ShawnVictor/Reaction_Control_System/README.md

# Reaction_Control_System
This is a repository containing all of the design documents relating to my Reaction Control System (RCS).
