ShawnVictor/Reaction_Control_System/Processing Code/Cold_Steer_Control_Panel/data/Cold_Steer_P&ID.jpg

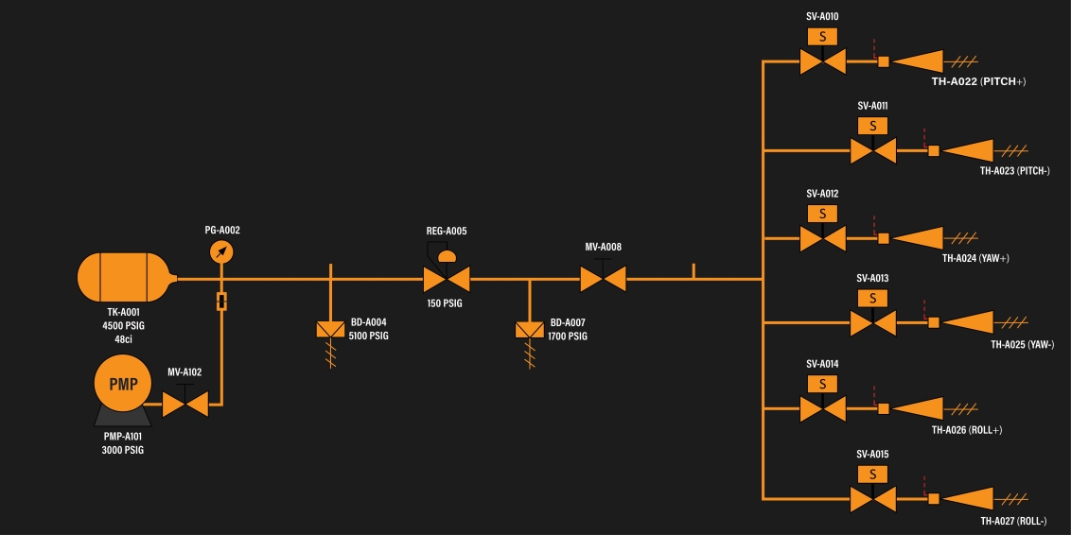
Processing Code/Cold_Steer_Control_Panel/data/Cold_Steer_P&ID.jpg
