ShawnVictor/Reaction_Control_System/Processing Code/Cold_Steer_Control_Panel/data/LRA_P&ID.jpg

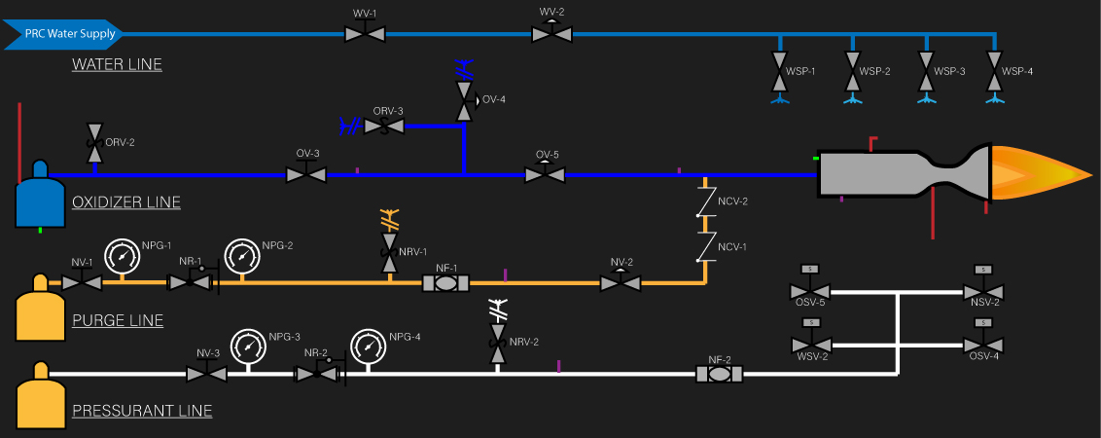
Processing Code/Cold_Steer_Control_Panel/data/LRA_P&ID.jpg
