ShawnVictor/Reaction_Control_System/Processing Code/Cold_Steer_Control_Panel/data/LRA_P&ID.png

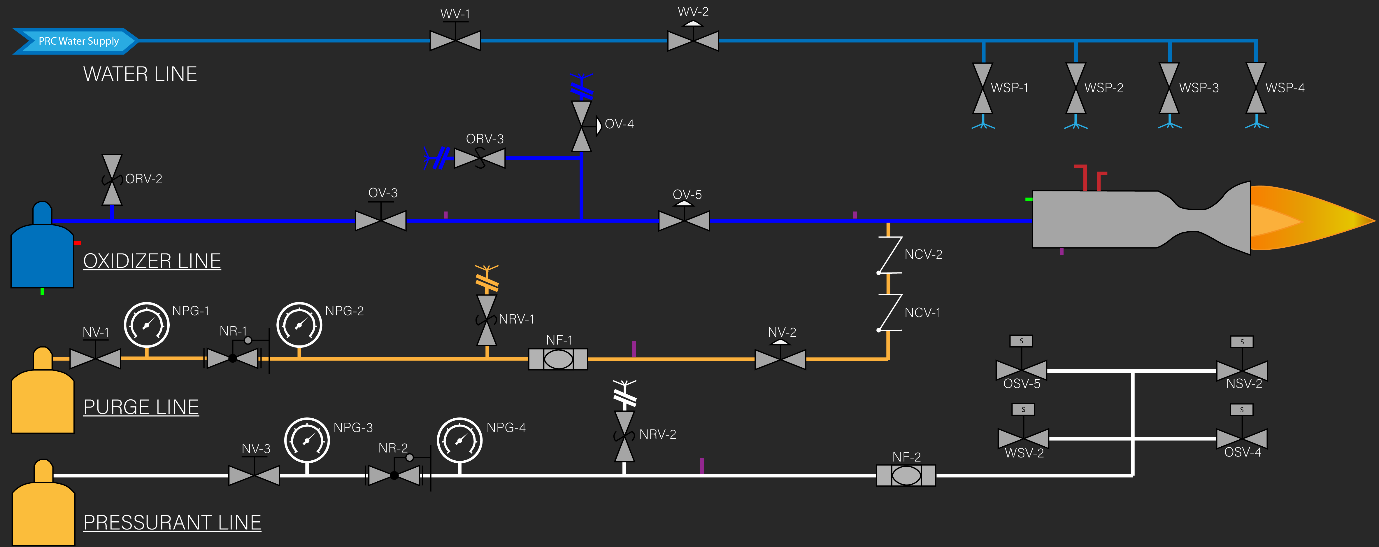
Processing Code/Cold_Steer_Control_Panel/data/LRA_P&ID.png
