ShawnVictor/Reaction_Control_System/PCB Files/Main_Control_Board/RCS_Metro_Telem_Board.brd

## EAGLE design PCB Files/Main_Control_Board/RCS_Metro_Telem_Board.brd (2024-12-17)

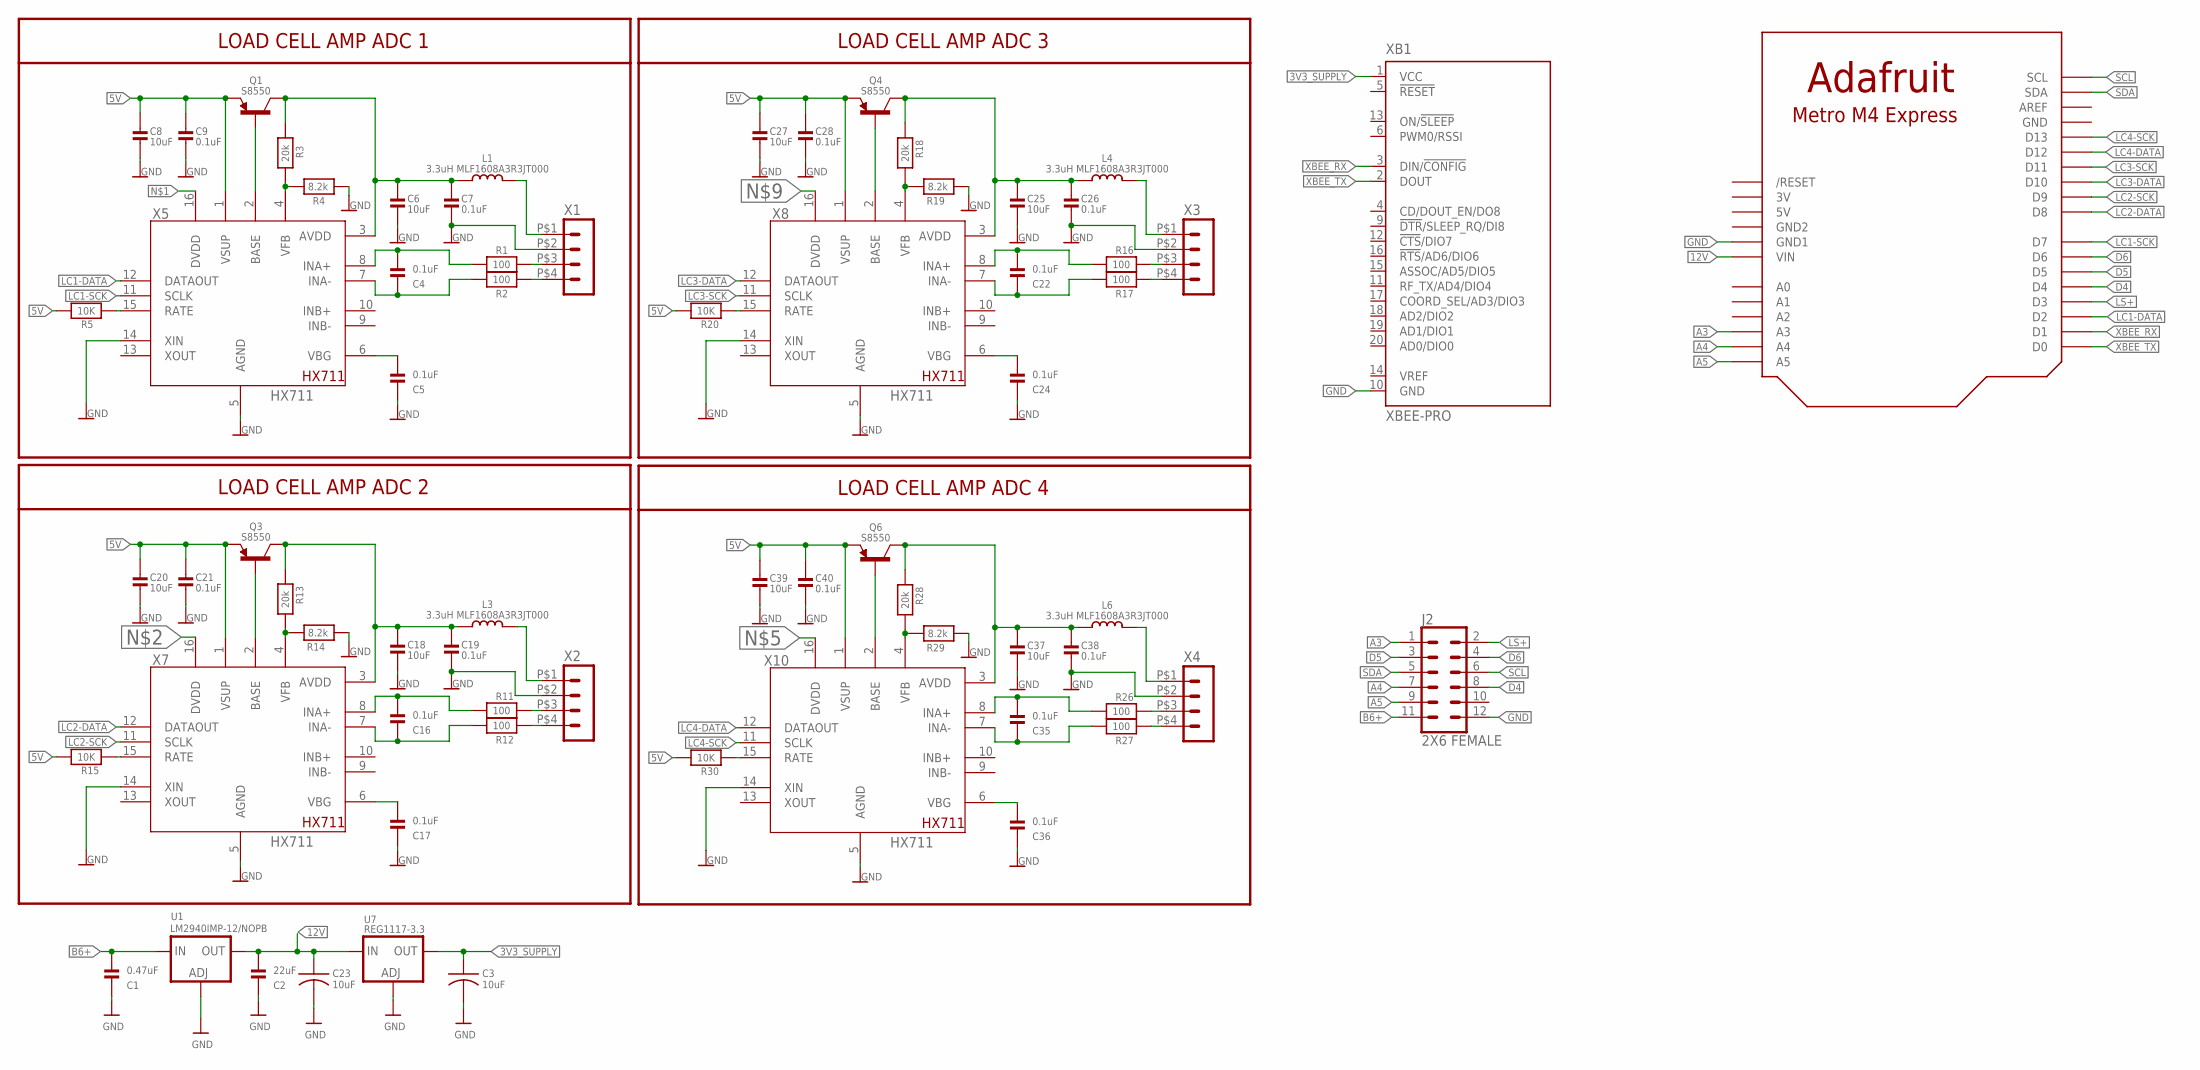
[picture p4: schematic RCS_Metro_Telem_Board.sch]

Parts:
C1: 0.47uF; 0603@1
C2: 22uF; 0603@1
C3, C23: 10uF; C0603
C4, C5, C7, C9, C16, C17, C19, C21, C22, C24, C26, C28, C35, C36, C38, C40: 0.1uF; 0603@1
C6, C8, C18, C20, C25, C27, C37, C39: 10uF; 0603@1
J2: 2X6 FEMALE; 2X6
L1, L3, L4, L6: 3.3uH MLF1608A3R3JT000; 0603-NO
Q1, Q3, Q4, Q6: S8550; SOT23-WIDE
R1, R2, R11, R12, R16, R17, R26, R27: 100; 0603@1
R3, R13, R18, R28: 20k; 0603@1
R4, R14, R19, R29: 8.2k; 0603@1
R5, R15, R20, R30: 10K; 0603@1
U1: LM2940IMP-12/NOPB; SOT223-R
U7: REG1117-3.3; SOT223-R
U$1: ADAFRUIT_METRO_M4_EXPRESS
X1, X2, X3, X4: HEADER_POS4_43650-0415; 43650-0415
X5, X7, X8, X10: HX711; SO16
XB1: XBEE-PRO

Connections:
3V: U$1.3V
3V3_SUPPLY: C3.1, U7.2 (OUT), XB1.1 (VCC)
5V: C8.2, C9.2, C20.2, C21.2, C27.2, C28.2, C39.2, C40.2, Q1.2 (E), Q3.2 (E), Q4.2 (E), Q6.2 (E), R5.1, R15.1, R20.1, R30.1, U$1.5V, X5.1 (VSUP), X7.1 (VSUP), X8.1 (VSUP), X10.1 (VSUP)
12V: C2.2, C23.1, U1.2 (OUT), U7.3 (IN), U$1.VIN
A3: J2.1, U$1.A3
A4: J2.7, U$1.A4
A5: J2.9, U$1.A5
B6+: C1.2, J2.11, U1.3 (IN)
D4: J2.8, U$1.D4
D5: J2.3, U$1.D5
D6: J2.4, U$1.D6
GND: C1.1, C2.1, C3.2, C5.1, C6.1, C7.1, C8.1, C9.1, C17.1, C18.1, C19.1, C20.1, C21.1, C23.2, C24.1, C25.1, C26.1, C27.1, C28.1, C36.1, C37.1, C38.1, C39.1, C40.1, J2.12, R4.1, R14.1, R19.1, R29.1, U1.1 (ADJ), U7.1 (ADJ), U$1.GND, U$1.GND1, X1.P$2 (2), X2.P$2 (2), X3.P$2 (2), X4.P$2 (2), X5.5 (AGND), X5.14 (XIN), X7.5 (AGND), X7.14 (XIN), X8.5 (AGND), X8.14 (XIN), X10.5 (AGND), X10.14 (XIN), XB1.10 (GND)
GND2: U$1.GND2
LC1-DATA: U$1.D2, X5.12 (DATAOUT)
LC1-SCK: U$1.D7, X5.11 (SCLK)
LC2-DATA: U$1.D8, X7.12 (DATAOUT)
LC2-SCK: U$1.D9, X7.11 (SCLK)
LC3-DATA: U$1.D10, X8.12 (DATAOUT)
LC3-SCK: U$1.D11, X8.11 (SCLK)
LC4-DATA: U$1.D12, X10.12 (DATAOUT)
LC4-SCK: U$1.D13, X10.11 (SCLK)
LS+: J2.2, U$1.D3
unnamed: R1.2, X1.P$3 (3)
unnamed: R2.2, X1.P$4 (4)
unnamed: C4.1, R2.1, X5.7 (INA-)
unnamed: C4.2, R1.1, X5.8 (INA+)
unnamed: C5.2, X5.6 (VBG)
unnamed: L1.2, X1.P$1 (1)
unnamed: R3.1, R4.2, X5.4 (VFB)
unnamed: Q1.1 (B), X5.2 (BASE)
unnamed: C6.2, C7.2, L1.1, Q1.3 (C), R3.2, X5.3 (AVDD)
unnamed: R5.2, X5.15 (RATE)
unnamed: R11.2, X2.P$3 (3)
unnamed: R12.2, X2.P$4 (4)
unnamed: C16.1, R12.1, X7.7 (INA-)
unnamed: C16.2, R11.1, X7.8 (INA+)
unnamed: C17.2, X7.6 (VBG)
unnamed: L3.2, X2.P$1 (1)
unnamed: R13.1, R14.2, X7.4 (VFB)
unnamed: Q3.1 (B), X7.2 (BASE)
unnamed: C18.2, C19.2, L3.1, Q3.3 (C), R13.2, X7.3 (AVDD)
unnamed: R15.2, X7.15 (RATE)
unnamed: R16.2, X3.P$3 (3)
unnamed: R17.2, X3.P$4 (4)
unnamed: C22.1, R17.1, X8.7 (INA-)
unnamed: C22.2, R16.1, X8.8 (INA+)
unnamed: C24.2, X8.6 (VBG)
unnamed: L4.2, X3.P$1 (1)
unnamed: R18.1, R19.2, X8.4 (VFB)
unnamed: Q4.1 (B), X8.2 (BASE)
unnamed: C25.2, C26.2, L4.1, Q4.3 (C), R18.2, X8.3 (AVDD)
unnamed: R20.2, X8.15 (RATE)
unnamed: R26.2, X4.P$3 (3)
unnamed: R27.2, X4.P$4 (4)
unnamed: C35.1, R27.1, X10.7 (INA-)
unnamed: C35.2, R26.1, X10.8 (INA+)
unnamed: C36.2, X10.6 (VBG)
unnamed: L6.2, X4.P$1 (1)
unnamed: R28.1, R29.2, X10.4 (VFB)
unnamed: Q6.1 (B), X10.2 (BASE)
unnamed: C37.2, C38.2, L6.1, Q6.3 (C), R28.2, X10.3 (AVDD)
unnamed: R30.2, X10.15 (RATE)
SCL: J2.6, U$1.SCL
SDA: J2.5, U$1.SDA
XBEE_RX: U$1.D1, XB1.3 (DIN/!CONFIG)
XBEE_TX: U$1.D0, XB1.2 (DOUT)

Notes on the sheet:
LOAD CELL AMP ADC 1
LOAD CELL AMP ADC 2
LOAD CELL AMP ADC 3
LOAD CELL AMP ADC 4

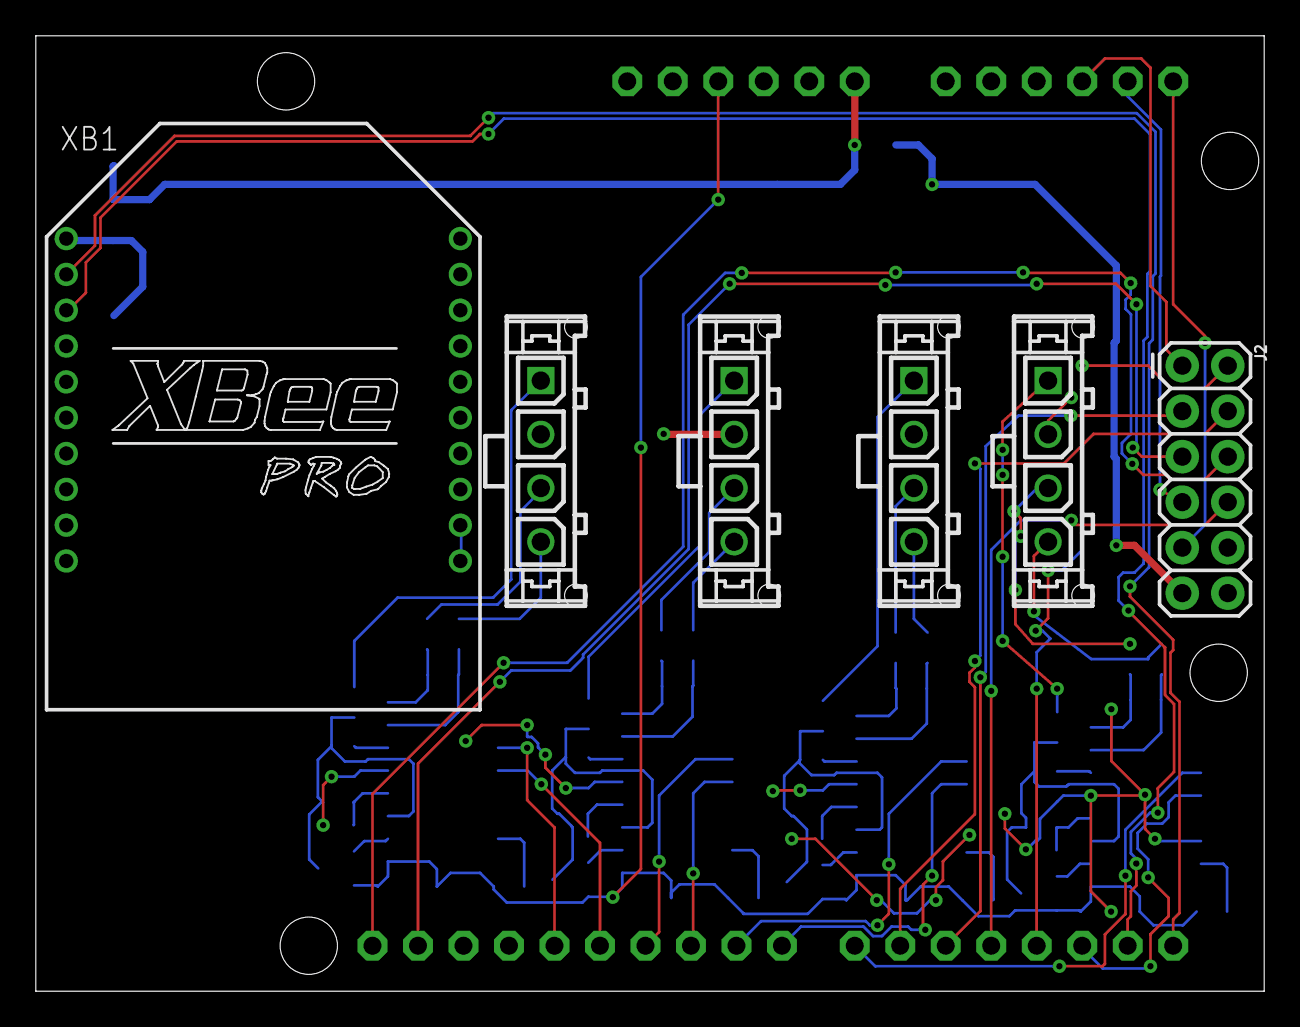
[picture p5: board RCS_Metro_Telem_Board.brd from above]

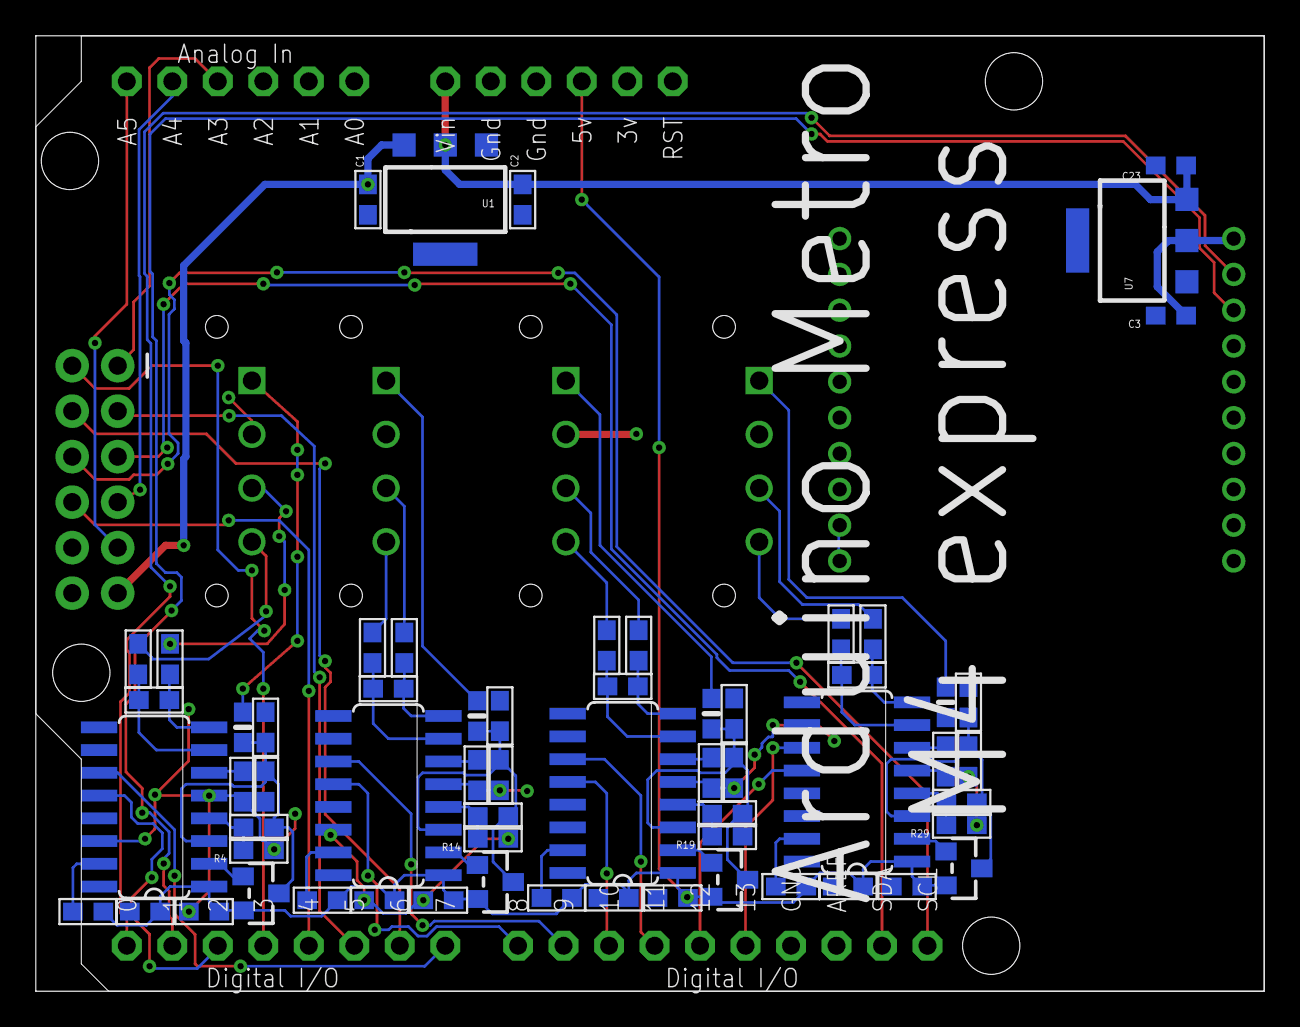
[picture p6: board RCS_Metro_Telem_Board.brd from below]

Board: 2 copper layers, 68.6 x 53.3 mm, 69 parts (63 on the bottom side), 64 nets.
