ShawnVictor/Reaction_Control_System/PCB Files/Battery_5S_Compression_Board/RCS_Battery_Pack_v2.brd

## EAGLE design PCB Files/Battery_5S_Compression_Board/RCS_Battery_Pack_v2.brd (2024-12-17)

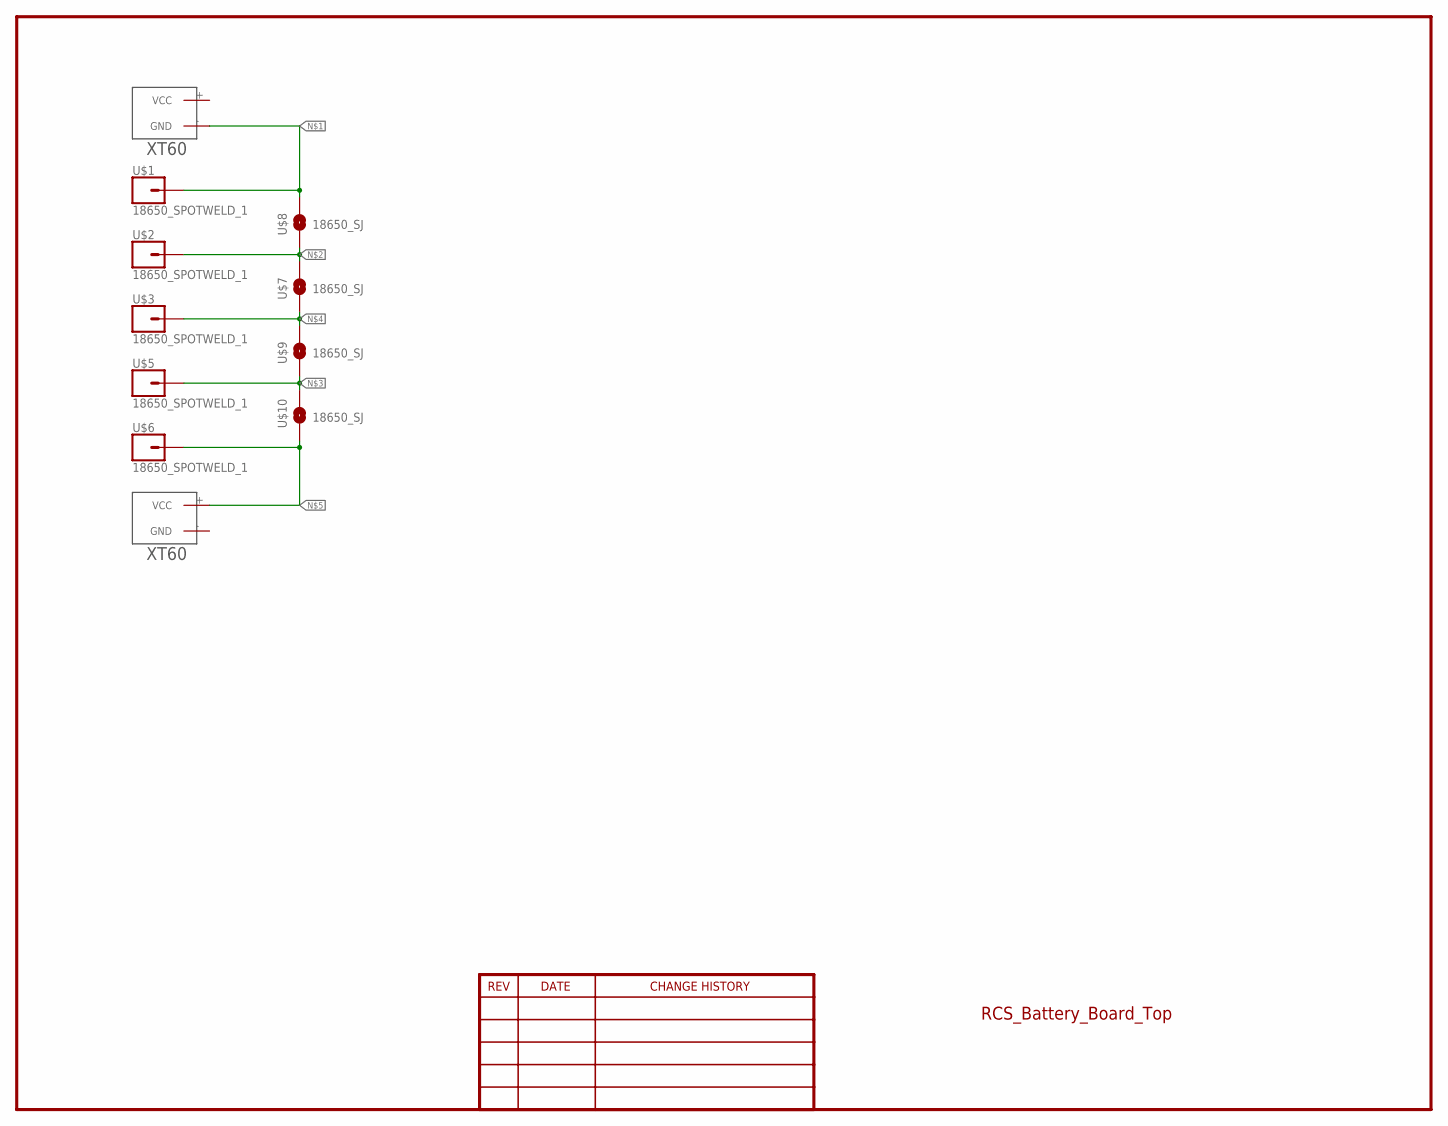
[picture p7: schematic RCS_Battery_Pack_v2.sch]

Parts:
U$1, U$2, U$3, U$5, U$6: 18650_SPOTWELD_1
U$4, U$11: XT60
U$7, U$8, U$9, U$10: 18650_SJ; SJ_2S-NO

Connections:
unnamed: U$1.1, U$4.- (GND), U$8.2
unnamed: U$2.1, U$7.2, U$8.1
unnamed: U$5.1, U$9.1, U$10.2
unnamed: U$3.1, U$7.1, U$9.2
unnamed: U$6.1, U$10.1, U$11.+ (VCC)

Notes on the sheet:
RCS_Battery_Board_Top

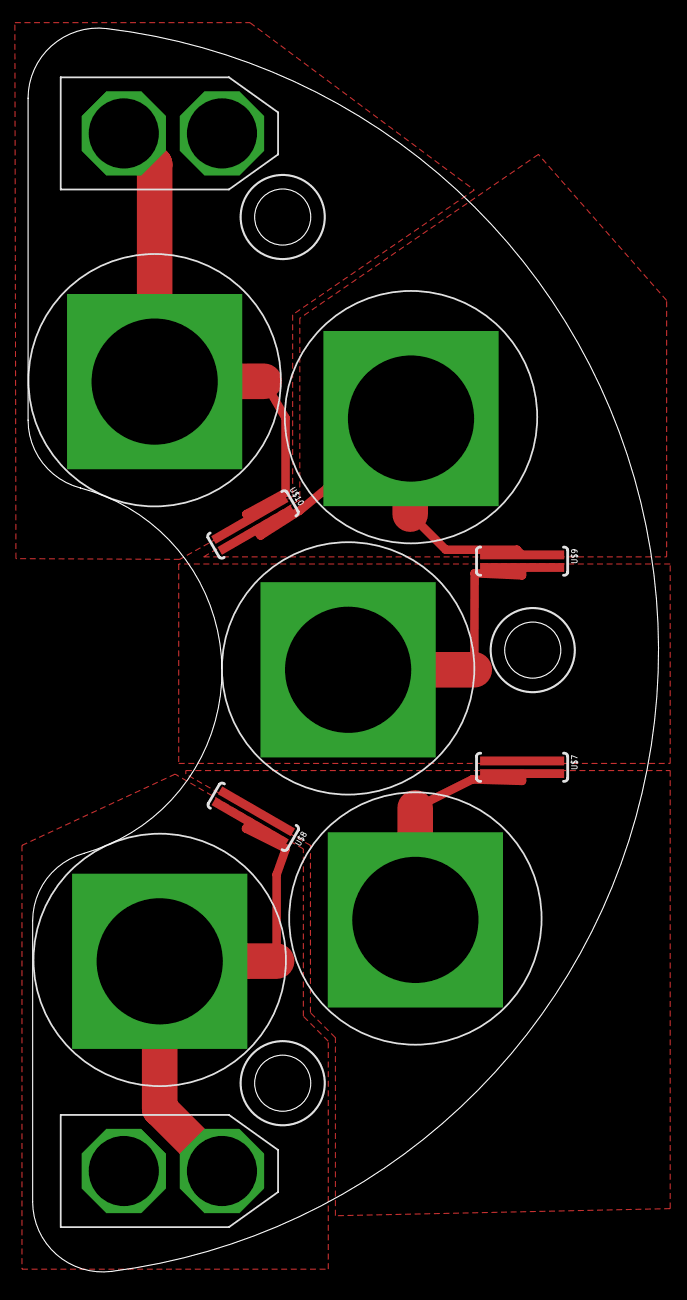
[picture p8: board RCS_Battery_Pack_v2.brd from above]

Board: 2 copper layers, 45.0 x 88.7 mm, 11 parts (0 on the bottom side), 5 nets.
