ShawnVictor/Reaction_Control_System/PCB Files/Main_Control_Board/RCS_Cntrl_Board.brd

## EAGLE design PCB Files/Main_Control_Board/RCS_Cntrl_Board.brd (2024-12-17)

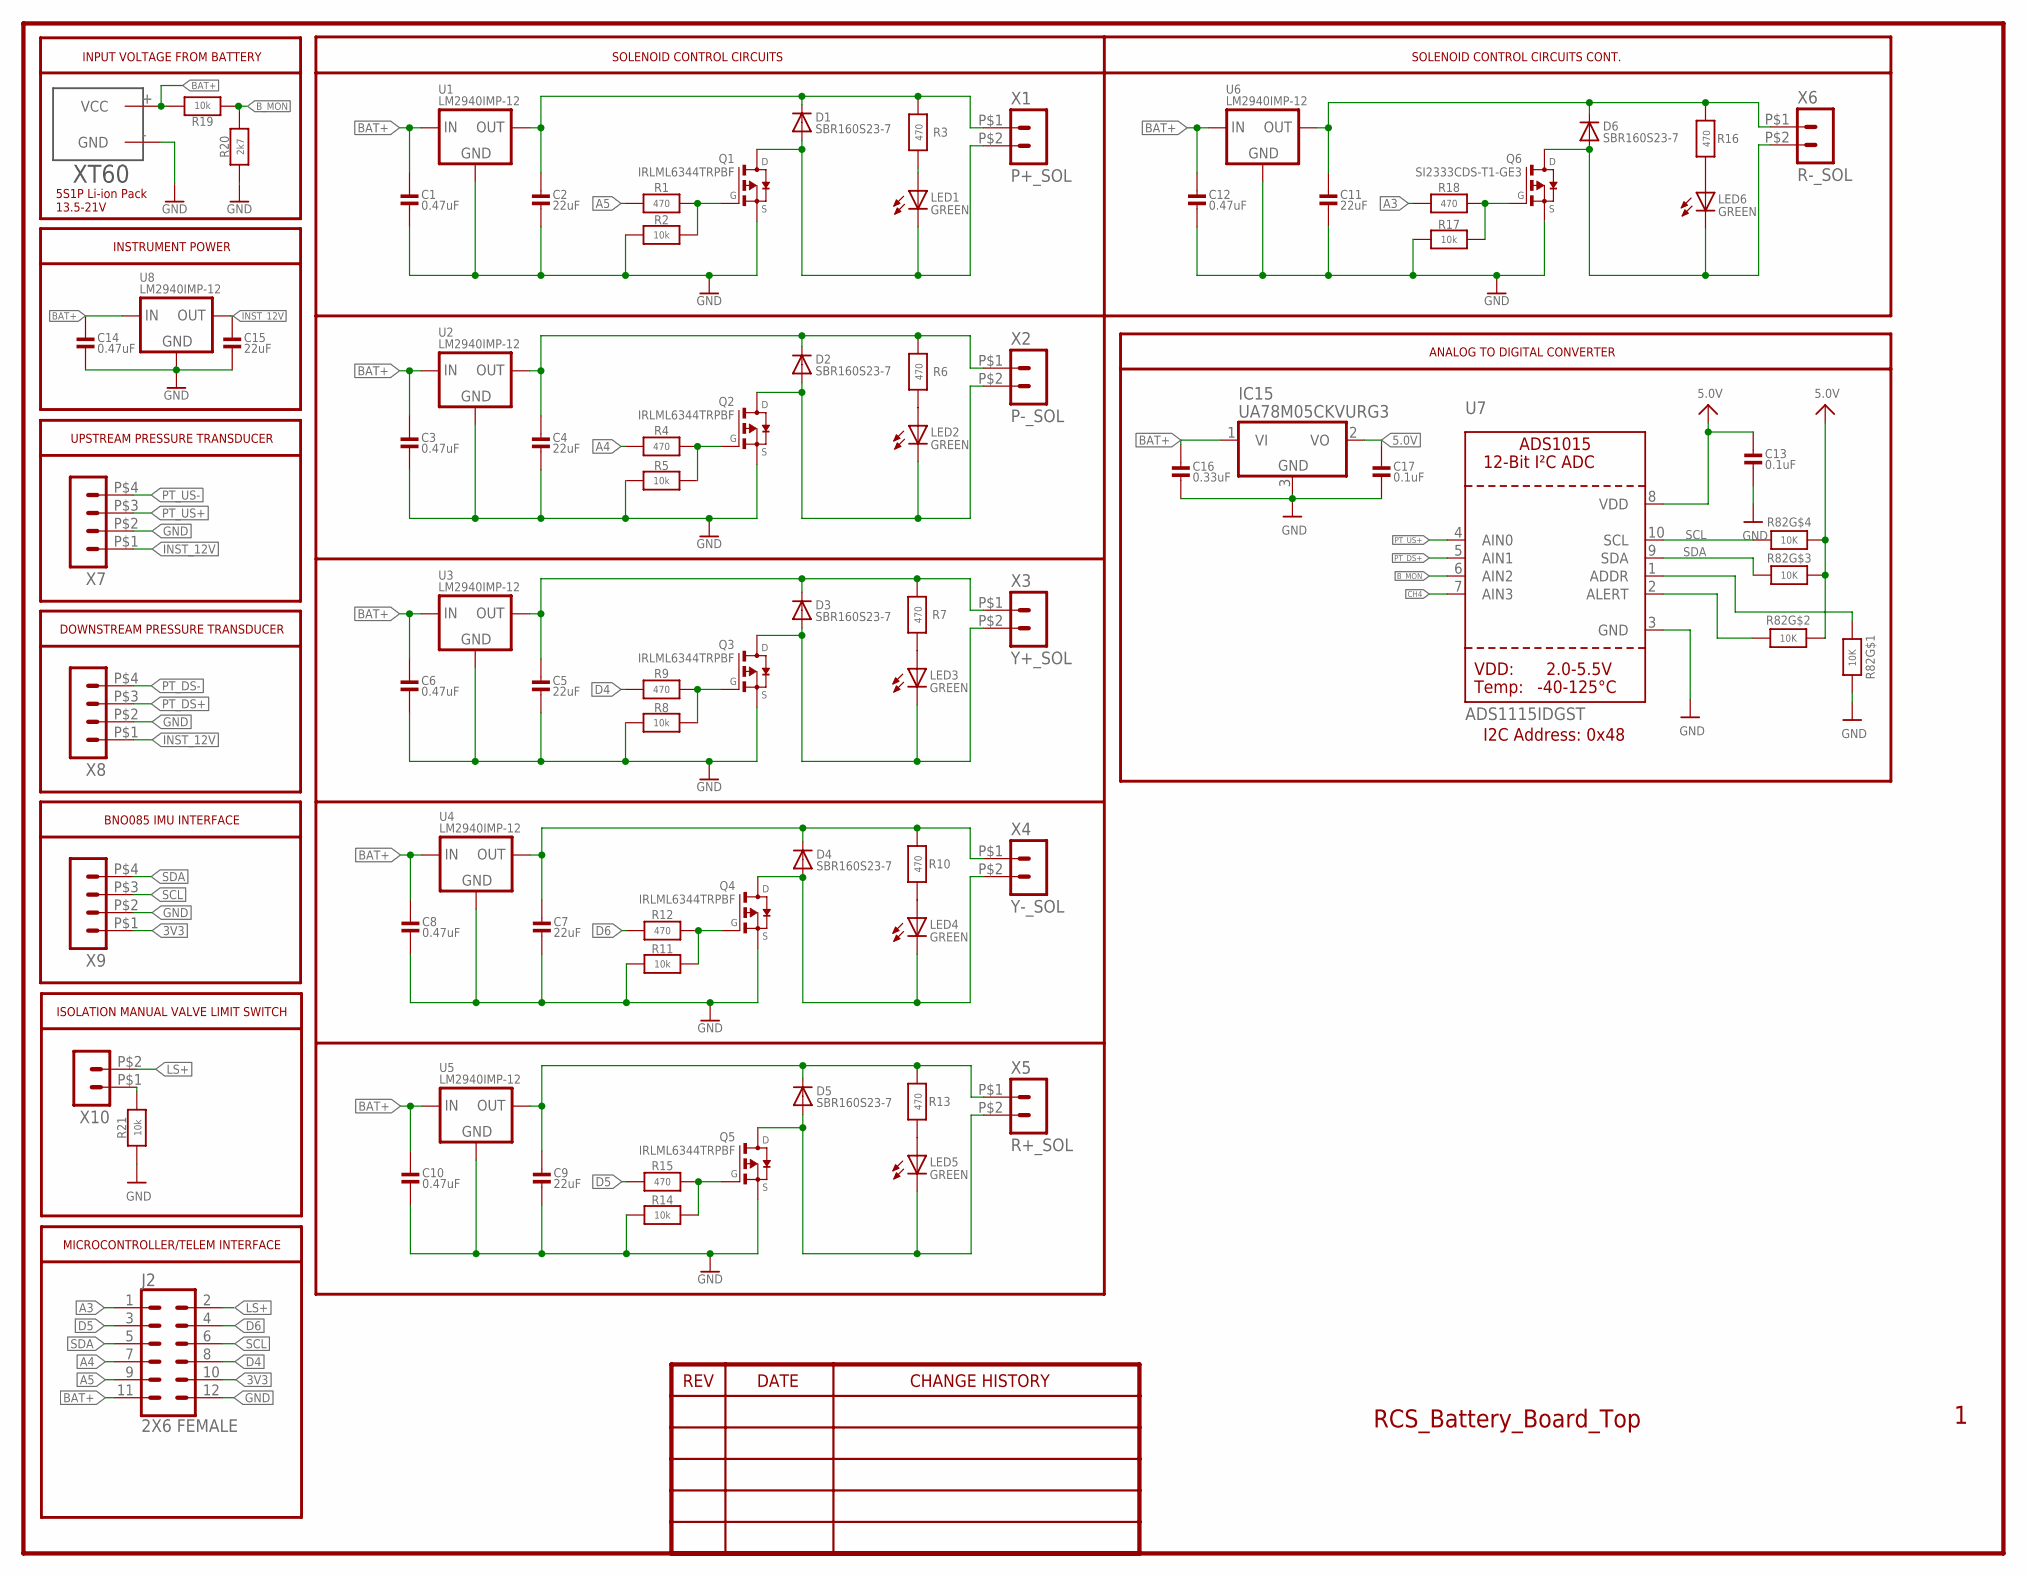
[picture p9: schematic RCS_Cntrl_Board.sch]

Parts:
C1, C3, C6, C8, C10, C12, C14: 0.47uF; 0603
C2, C4, C5, C7, C9, C11, C15: 22uF; 0603
C13, C17: 0.1uF; 0603
C16: 0.33uF; 0603
D1, D2, D3, D4, D5, D6: SBR160S23-7; SOT23-R
IC15: UA78M05CKVURG3; TO252
J2: 2X6 FEMALE; 2X6
LED1, LED2, LED3, LED4, LED5, LED6: GREEN; CHIPLED_0603
Q1, Q2, Q3, Q4, Q5: IRLML6344TRPBF; TRANSISTOR-FET_SOT23
Q6: SI2333CDS-T1-GE3; TRANSISTOR-FET_SOT23
R1, R3, R4, R6, R7, R9, R10, R12, R13, R15, R16, R18: 470; 0603-NO
R2, R5, R8, R11, R14, R17, R19, R21: 10k; 0603-NO
R20: 2k7; 0603-NO
R82: 10K; RESPACK_4X0603
U1, U2, U3, U4, U5, U6, U8: LM2940IMP-12; SOT223-R
U7: ADS1115IDGST; MSOP10
U$4: XT60
X1: P+_SOL; 44914-0201
X2: P-_SOL; 44914-0201
X3: Y+_SOL; 44914-0201
X4: Y-_SOL; 44914-0201
X5: R+_SOL; 44914-0201
X6: R-_SOL; 44914-0201
X7, X8, X9: HEADER_POS4_43650-0415; 43650-0415
X10: HEADER_POS2_43650-0215; 43650-0215

Connections:
3V3: J2.10, X9.P$1 (1)
5.0V: C13.2, C17.2, IC15.2 (VO), R82.5 (2), R82.6 (2), R82.7 (2), U7.8 (VDD)
A3: J2.1, R18.1
A4: J2.7, R4.1
A5: J2.9, R1.1
BAT+: C1.2, C3.2, C6.2, C8.2, C10.2, C12.2, C14.2, C16.2, IC15.1 (VI), J2.11, R19.2, U1.1 (IN), U2.1 (IN), U3.1 (IN), U4.1 (IN), U5.1 (IN), U6.1 (IN), U8.1 (IN), U$4.+ (VCC)
B_MON: R19.1, R20.2, U7.6 (AIN2)
CH4: U7.7 (AIN3)
D4: J2.8, R9.1
D5: J2.3, R15.1
D6: J2.4, R12.1
GND: C1.1, C2.1, C3.1, C4.1, C5.1, C6.1, C7.1, C8.1, C9.1, C10.1, C11.1, C12.1, C13.1, C14.1, C15.1, C16.1, C17.1, IC15.3 (GND), J2.12, Q1.2 (S), Q2.2 (S), Q3.2 (S), Q4.2 (S), Q5.2 (S), Q6.2 (S), R2.1, R5.1, R8.1, R11.1, R14.1, R17.1, R20.1, R21.1, R82.8 (2), U1.2 (GND), U2.2 (GND), U3.2 (GND), U4.2 (GND), U5.2 (GND), U6.2 (GND), U7.3 (GND), U8.2 (GND), U$4.- (GND), X7.P$2 (2), X8.P$2 (2), X9.P$2 (2)
INST_12V: C15.2, U8.3 (OUT), X7.P$1 (1), X8.P$1 (1)
LS+: J2.2, X10.P$2 (2)
unnamed: LED1.A, R3.1
unnamed: C2.2, D1.3 (C), R3.2, U1.3 (OUT), X1.P$1 (1)
unnamed: D2.1 (A), LED2.C, Q2.3 (D), X2.P$2 (2)
unnamed: LED2.A, R6.1
unnamed: Q2.1 (G), R4.2, R5.2
unnamed: D3.1 (A), LED3.C, Q3.3 (D), X3.P$2 (2)
unnamed: Q3.1 (G), R8.2, R9.2
unnamed: C4.2, D2.3 (C), R6.2, U2.3 (OUT), X2.P$1 (1)
unnamed: LED3.A, R7.1
unnamed: D4.1 (A), LED4.C, Q4.3 (D), X4.P$2 (2)
unnamed: D5.1 (A), LED5.C, Q5.3 (D), X5.P$2 (2)
unnamed: C5.2, D3.3 (C), R7.2, U3.3 (OUT), X3.P$1 (1)
unnamed: LED4.A, R10.1
unnamed: Q4.1 (G), R11.2, R12.2
unnamed: C7.2, D4.3 (C), R10.2, U4.3 (OUT), X4.P$1 (1)
unnamed: Q5.1 (G), R14.2, R15.2
unnamed: LED5.A, R13.1
unnamed: D6.1 (A), LED6.C, Q6.3 (D), X6.P$2 (2)
unnamed: Q6.1 (G), R17.2, R18.2
unnamed: C9.2, D5.3 (C), R13.2, U5.3 (OUT), X5.P$1 (1)
unnamed: LED6.A, R16.1
unnamed: C11.2, D6.3 (C), R16.2, U6.3 (OUT), X6.P$1 (1)
unnamed: R21.2, X10.P$1 (1)
unnamed: D1.1 (A), LED1.C, Q1.3 (D), X1.P$2 (2)
unnamed: Q1.1 (G), R1.2, R2.2
unnamed: R82.2 (1), U7.2 (ALERT)
unnamed: R82.1, U7.1 (ADDR)
PT_DS+: U7.5 (AIN1), X8.P$3 (3)
PT_DS-: X8.P$4 (4)
PT_US+: U7.4 (AIN0), X7.P$3 (3)
PT_US-: X7.P$4 (4)
SCL: J2.6, R82.4 (1), U7.10 (SCL), X9.P$3 (3)
SDA: J2.5, R82.3 (1), U7.9 (SDA), X9.P$4 (4)

Notes on the sheet:
RCS_Battery_Board_Top
INPUT VOLTAGE FROM BATTERY
5S1P Li-ion Pack
13.5-21V
SOLENOID CONTROL CIRCUITS
SOLENOID CONTROL CIRCUITS CONT.
ANALOG TO DIGITAL CONVERTER
I2C Address: 0x48
UPSTREAM PRESSURE TRANSDUCER
DOWNSTREAM PRESSURE TRANSDUCER
INSTRUMENT POWER
BNO085 IMU INTERFACE
ISOLATION MANUAL VALVE LIMIT SWITCH
MICROCONTROLLER/TELEM INTERFACE

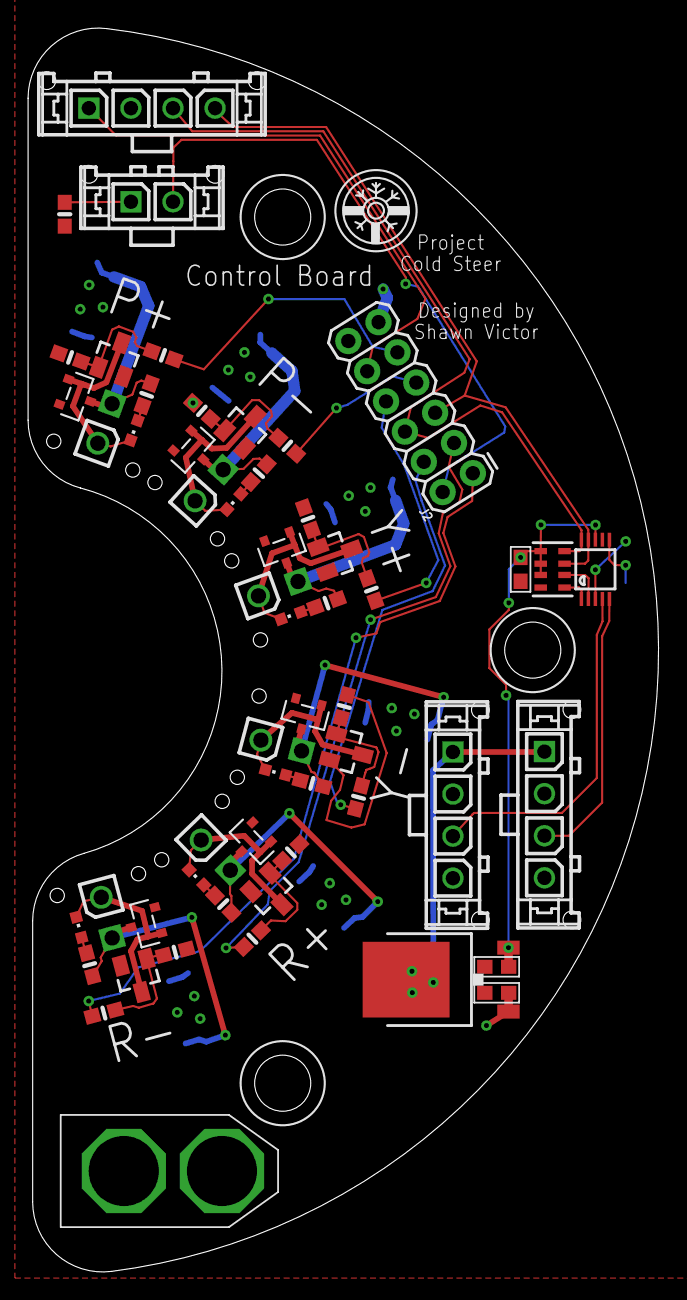
[picture p10: board RCS_Cntrl_Board.brd from above]

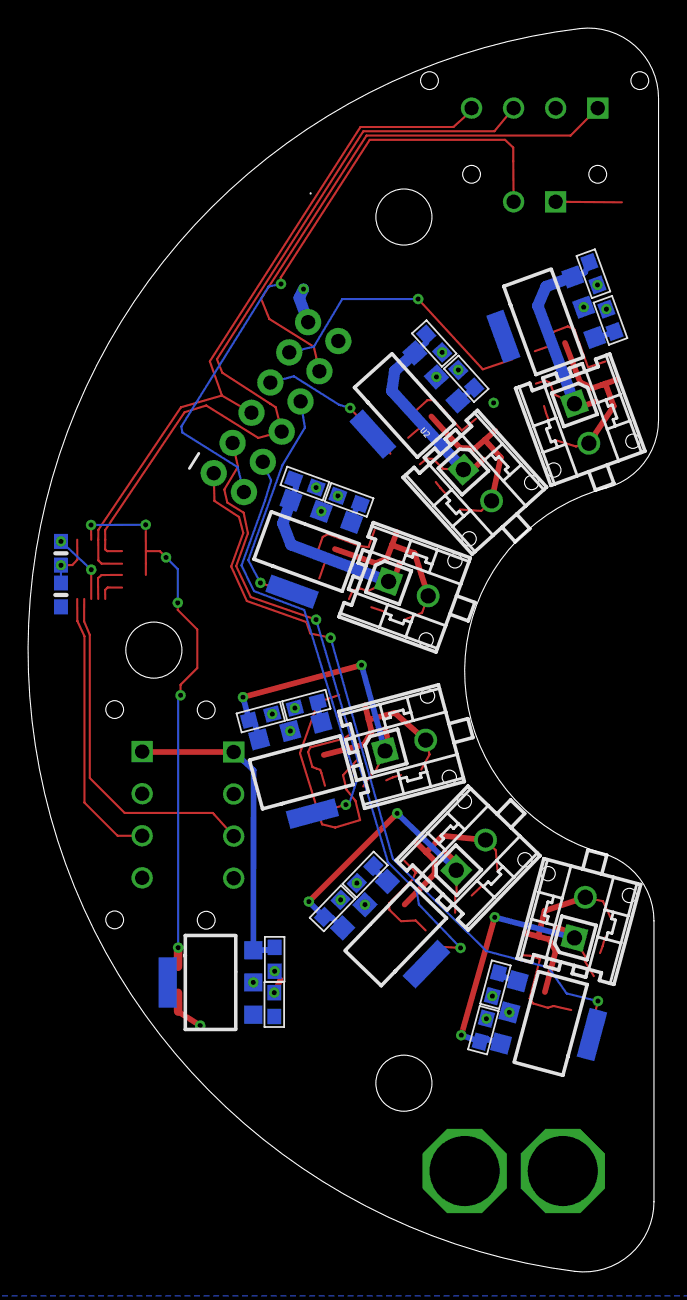
[picture p11: board RCS_Cntrl_Board.brd from below]

Board: 2 copper layers, 45.0 x 88.7 mm, 78 parts (29 on the bottom side), 44 nets.
