ShawnVictor/Reaction_Control_System/PCB Files/Compressor_Controller_Board/Compressor_Remote_Cntrl_Board.brd

## EAGLE design PCB Files/Compressor_Controller_Board/Compressor_Remote_Cntrl_Board.brd (2024-12-17)

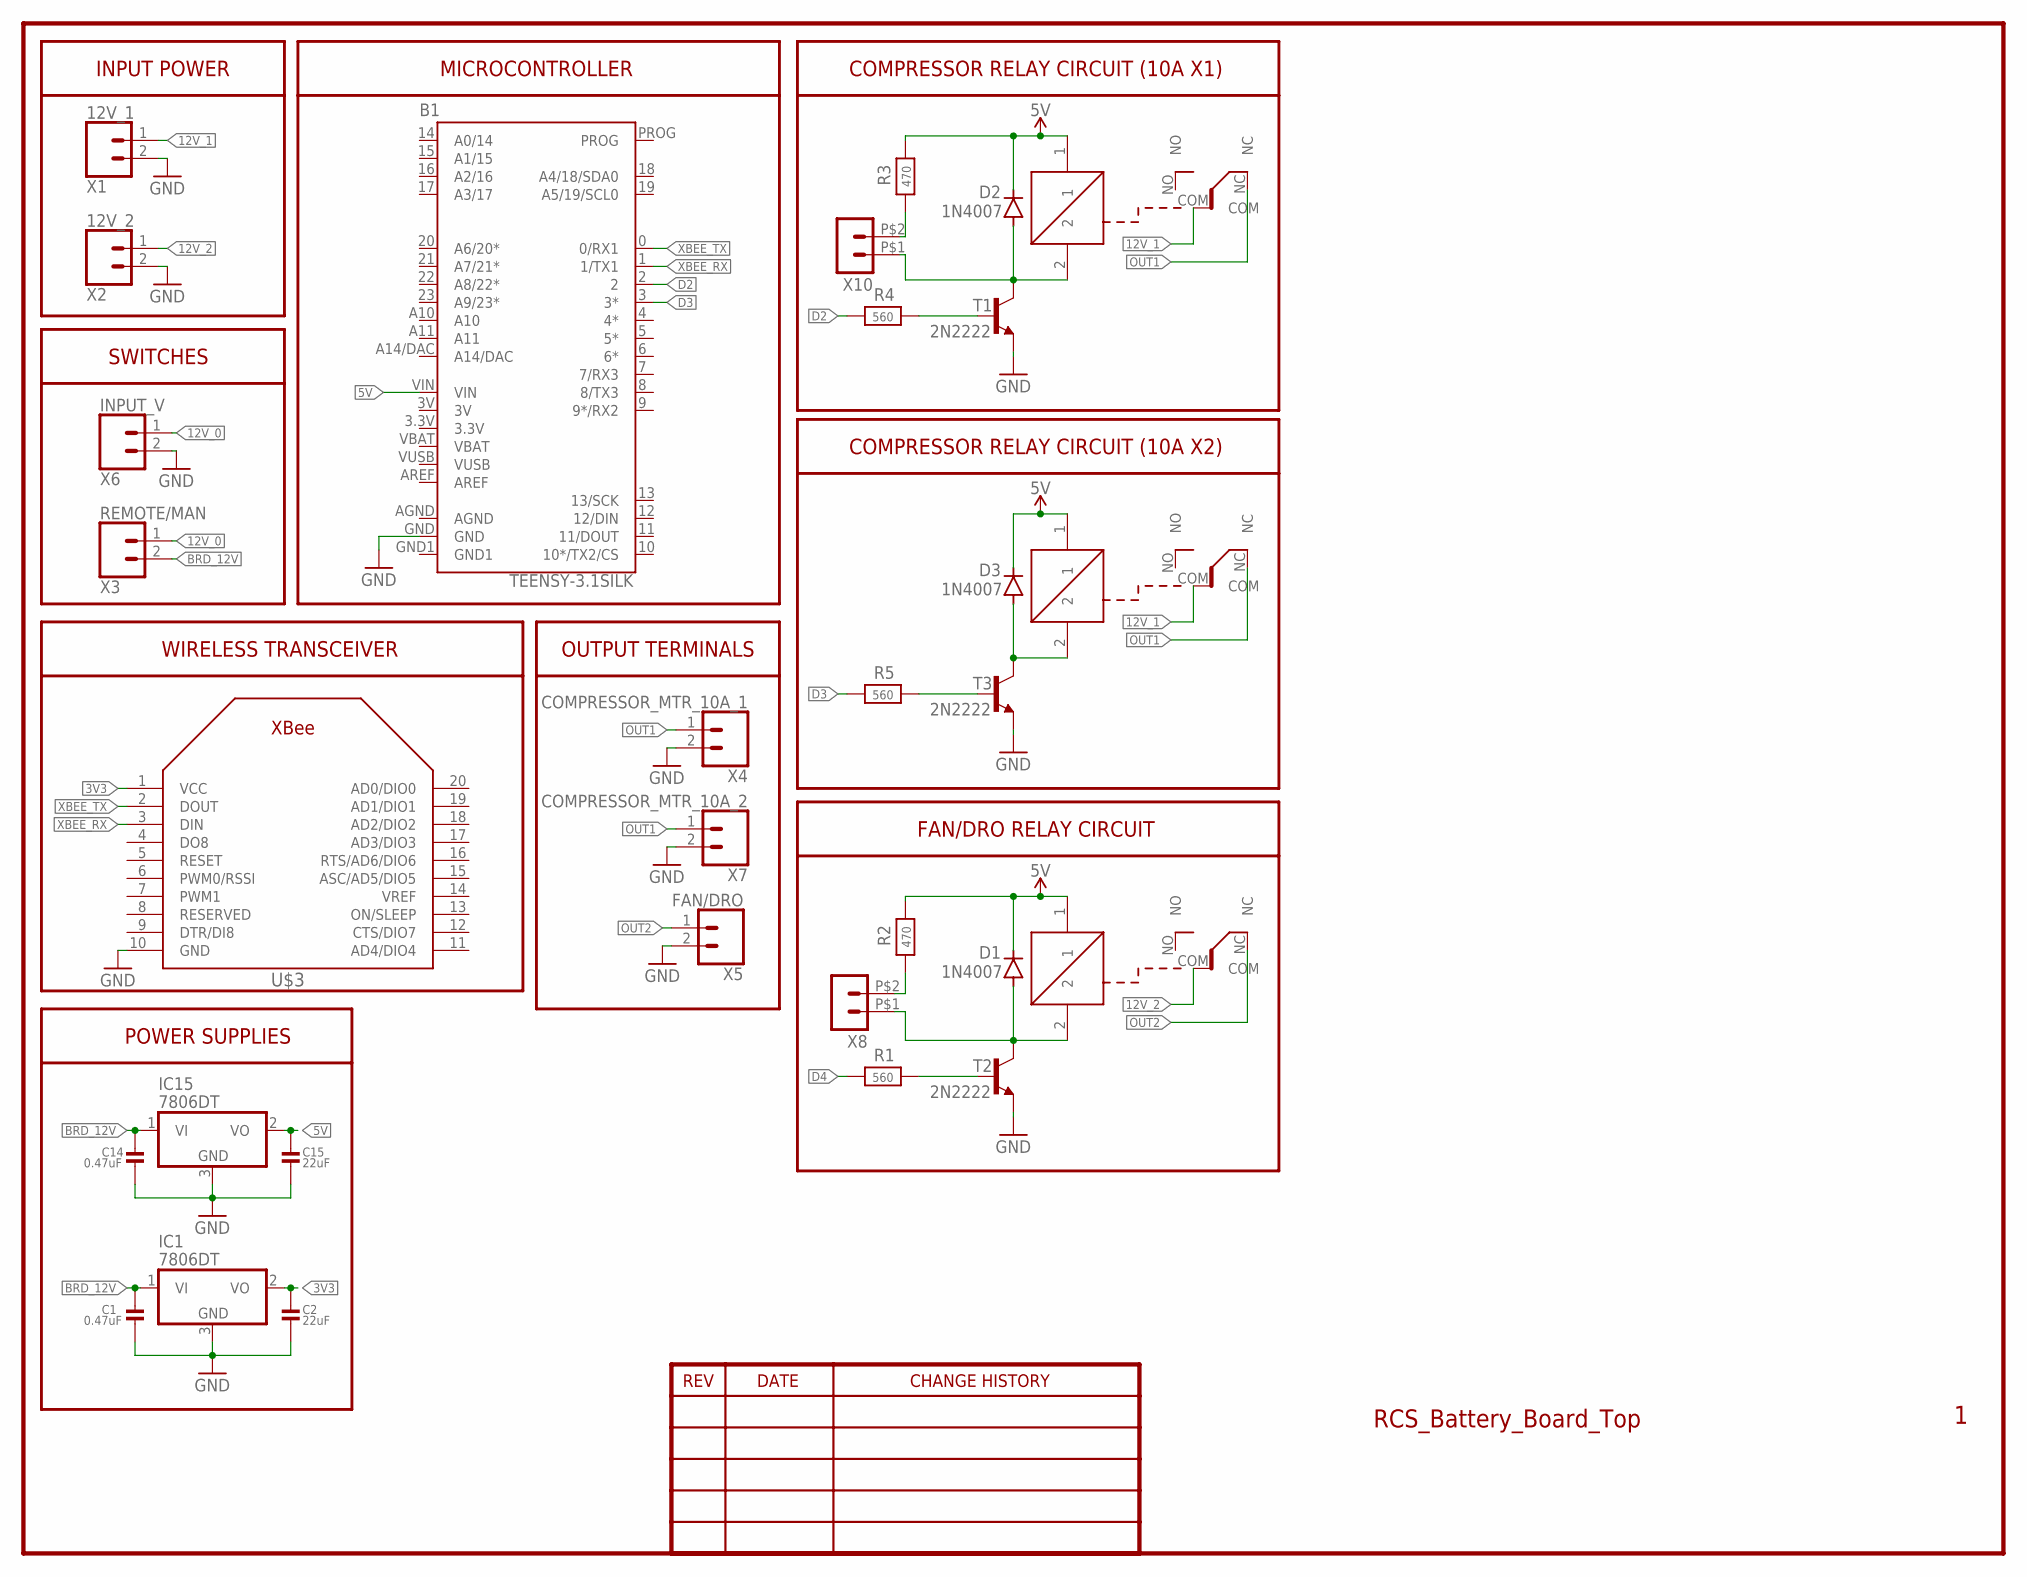
[picture p12: schematic Compressor_Remote_Cntrl_Board.sch]

Parts:
B1: TEENSY-3.1SILK; TEENSY-3.1
C1, C14: 0.47uF; 0603
C2, C15: 22uF; 0603
D1, D2, D3: 1N4007; DO-41
IC1, IC15: 7806DT; TO252
R1, R4, R5: 560; 0805
R2, R3: 470; 0805
T1, T2, T3: 2N2222; TO92-EBC-OVAL
U$1, U$2, U$4: RW-SH
U$3: XBEE
X1: 12V_1; SCREWTERMINAL-5MM-2
X2: 12V_2; SCREWTERMINAL-5MM-2
X3: REMOTE/MAN; SCREWTERMINAL-5MM-2
X4: COMPRESSOR_MTR_10A_1; SCREWTERMINAL-5MM-2
X5: FAN/DRO; SCREWTERMINAL-5MM-2
X6: INPUT_V; SCREWTERMINAL-5MM-2
X7: COMPRESSOR_MTR_10A_2; SCREWTERMINAL-5MM-2
X8, X10: HEADER_POS2_43650-0215; 43650-0215

Connections:
3.3V: B1.3.3V
3V: B1.3V
3V3: C2.2, IC1.2 (VO), U$3.1 (VCC)
5V: B1.VIN, C15.2, D1.C, D2.C, D3.C, IC15.2 (VO), R2.2, R3.2, U$1.1, U$2.1, U$4.1
12V_0: X3.1, X6.1
12V_1: U$2.COM, U$4.COM, X1.1
12V_2: U$1.COM, X2.1
AGND: B1.AGND
BRD_12V: C1.2, C14.2, IC1.1 (VI), IC15.1 (VI), X3.2
D2: B1.2, R4.1
D3: B1.3 (3*), R5.1
D4: R1.1
GND: B1.GND, C1.1, C2.1, C14.1, C15.1, IC1.3 (GND), IC15.3 (GND), T1.E, T2.E, T3.E, U$3.10 (GND), X1.2, X2.2, X4.2, X5.2, X6.2, X7.2
GND1: B1.GND1
unnamed: D1.A, T2.C, U$1.2, X8.P$1 (1)
unnamed: R1.2, T2.B
unnamed: R2.1, X8.P$2 (2)
unnamed: D3.A, T3.C, U$4.2
unnamed: R5.2, T3.B
unnamed: R4.2, T1.B
unnamed: D2.A, T1.C, U$2.2, X10.P$1 (1)
unnamed: R3.1, X10.P$2 (2)
OUT1: U$2.NC, U$4.NC, X4.1, X7.1
OUT2: U$1.NC, X5.1
VBAT: B1.VBAT
VUSB: B1.VUSB
XBEE_RX: B1.1 (1/TX1), U$3.3 (DIN)
XBEE_TX: B1.0 (0/RX1), U$3.2 (DOUT)

Notes on the sheet:
RCS_Battery_Board_Top
INPUT POWER
SWITCHES
COMPRESSOR RELAY CIRCUIT (10A X1)
FAN/DRO RELAY CIRCUIT
OUTPUT TERMINALS
MICROCONTROLLER
POWER SUPPLIES
WIRELESS TRANSCEIVER
COMPRESSOR RELAY CIRCUIT (10A X2)

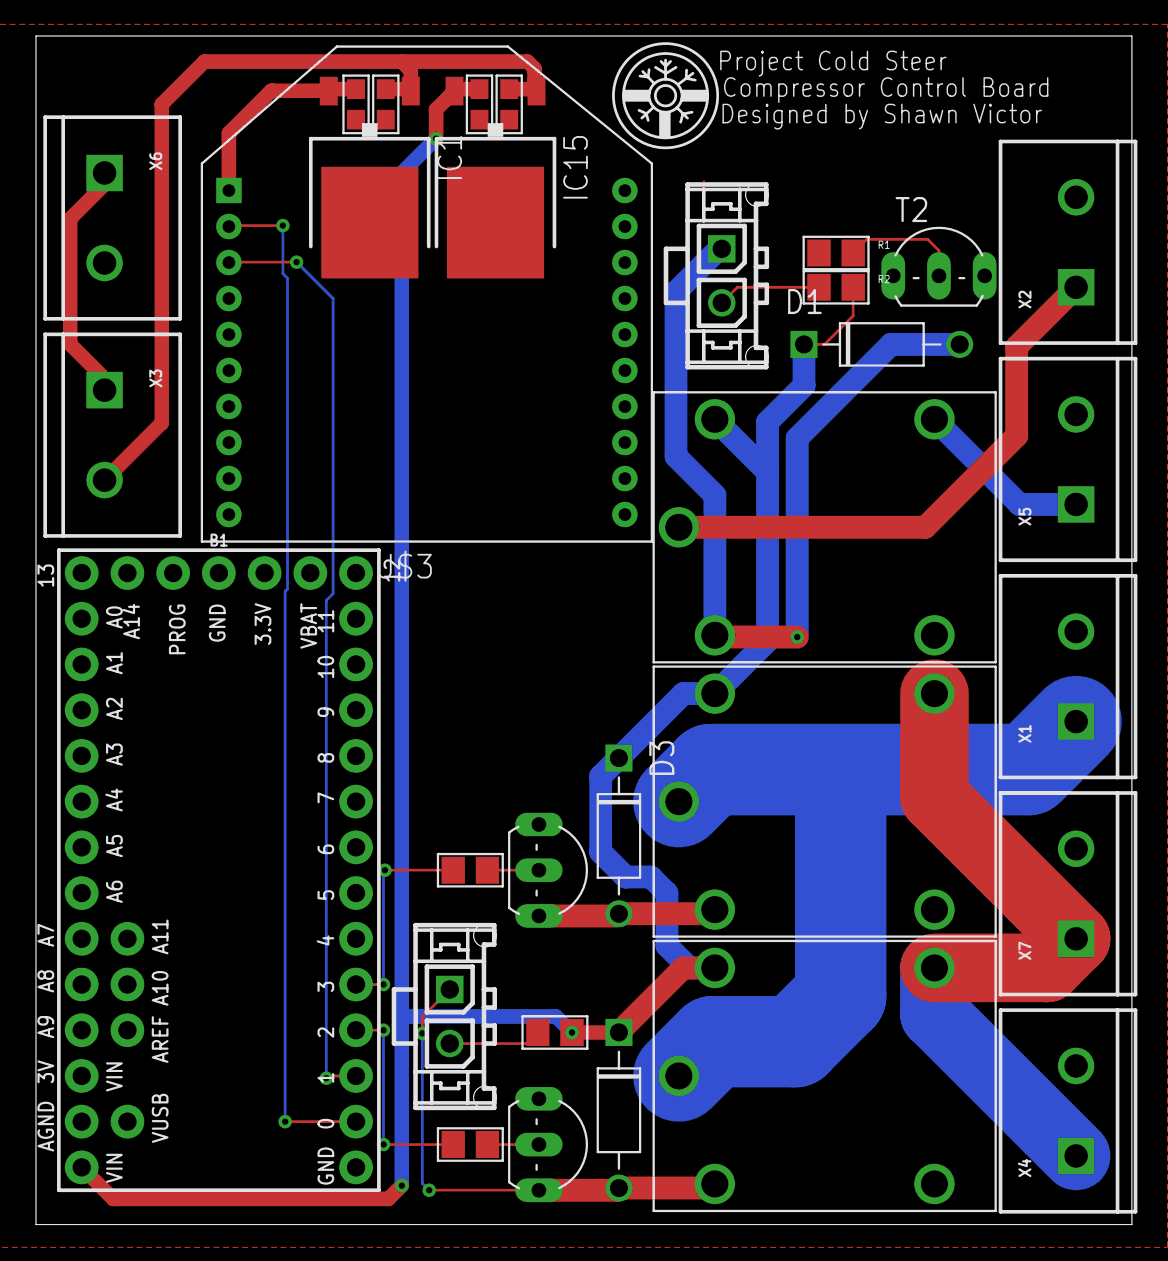
[picture p13: board Compressor_Remote_Cntrl_Board.brd from above]

Board: 2 copper layers, 60.9 x 66.0 mm, 31 parts (0 on the bottom side), 21 nets.
