ShawnVictor/Reaction_Control_System/(commit log)

2024-12-17 Initial Codebase Commit
    [Compressor_Remote_Cntrl_Board.brd, Compressor_Remote_Cntrl_Board.sch, RCS_Battery_Pack_v2.brd, RCS_Battery_Pack_v2.sch, RCS_Cntrl_Board.brd, RCS_Cntrl_Board.sch]
2024-12-17 Added PCB Files for Metro Shield Board
    [RCS_Metro_Telem_Board.brd, RCS_Metro_Telem_Board.sch]
2024-12-30 Processing Code now runs, but has bugs
    [Cold_Steer_Control_Panel.pde]
2024-12-30 Plotting Works now, reading in US/DS Pressure
2024-12-31 Processing GUI working with live sensor plots/watchdogs
2024-12-31 Added event handling for toggle switching
2024-12-31 Logging Functionality works
    [RCS_Log_100g_Up.csv, RCS_Log_10g_Up.csv, RCS_Log_110g_Up.csv, RCS_Log_120g_Up.csv, RCS_Log_130g_Up.csv, RCS_Log_140g_Up.csv, RCS_Log_150g_Up.csv, RCS_Log_160g_Up.csv]
2024-12-31 fixed issue where datapackets were 16bit and LC data was wrapping around
    [RCS_Main_Controller.ino]
2025-01-02 Working GUI with scaled lc2
    [RCS_Log_1000g.csv, RCS_Log_100g_Up.csv, RCS_Log_10g_Up.csv, RCS_Log_110g_Up.csv, RCS_Log_120g_Up.csv, RCS_Log_130g_Up.csv, RCS_Log_140g_Up.csv, RCS_Log_1500g.csv]
2025-01-05 Added Code for TX/RX functionality & Valve Commandability
2025-01-05 Working Version w/ Valve Commandability.
    [RCS_Log_1500g.csv, RCS_Log_2000g.csv, RCS_Log_20250103_211552.csv, RCS_Log_2500g.csv, RCS_Log_3000g.csv, RCS_Log_3500g.csv, RCS_Log_4000g.csv, RCS_Log_4500g.csv]
