ShawnVictor/Reaction_Control_System/(notices)

Notices in the files:
parts and their libraries:
dframes: Copyright (C) 2004, Bob Starr (bobstarr@mindspring.com)
SparkFun-PowerSymbols: Licensing: Creative Commons ShareAlike 4.0 International - https://creativecommons.org/licenses/by-sa/4.0
